aledomu/HispalisFPGA/board/HispalisFPGA.kicad_pcb

## KiCad design board/HispalisFPGA.kicad_pcb (2025-04-14)

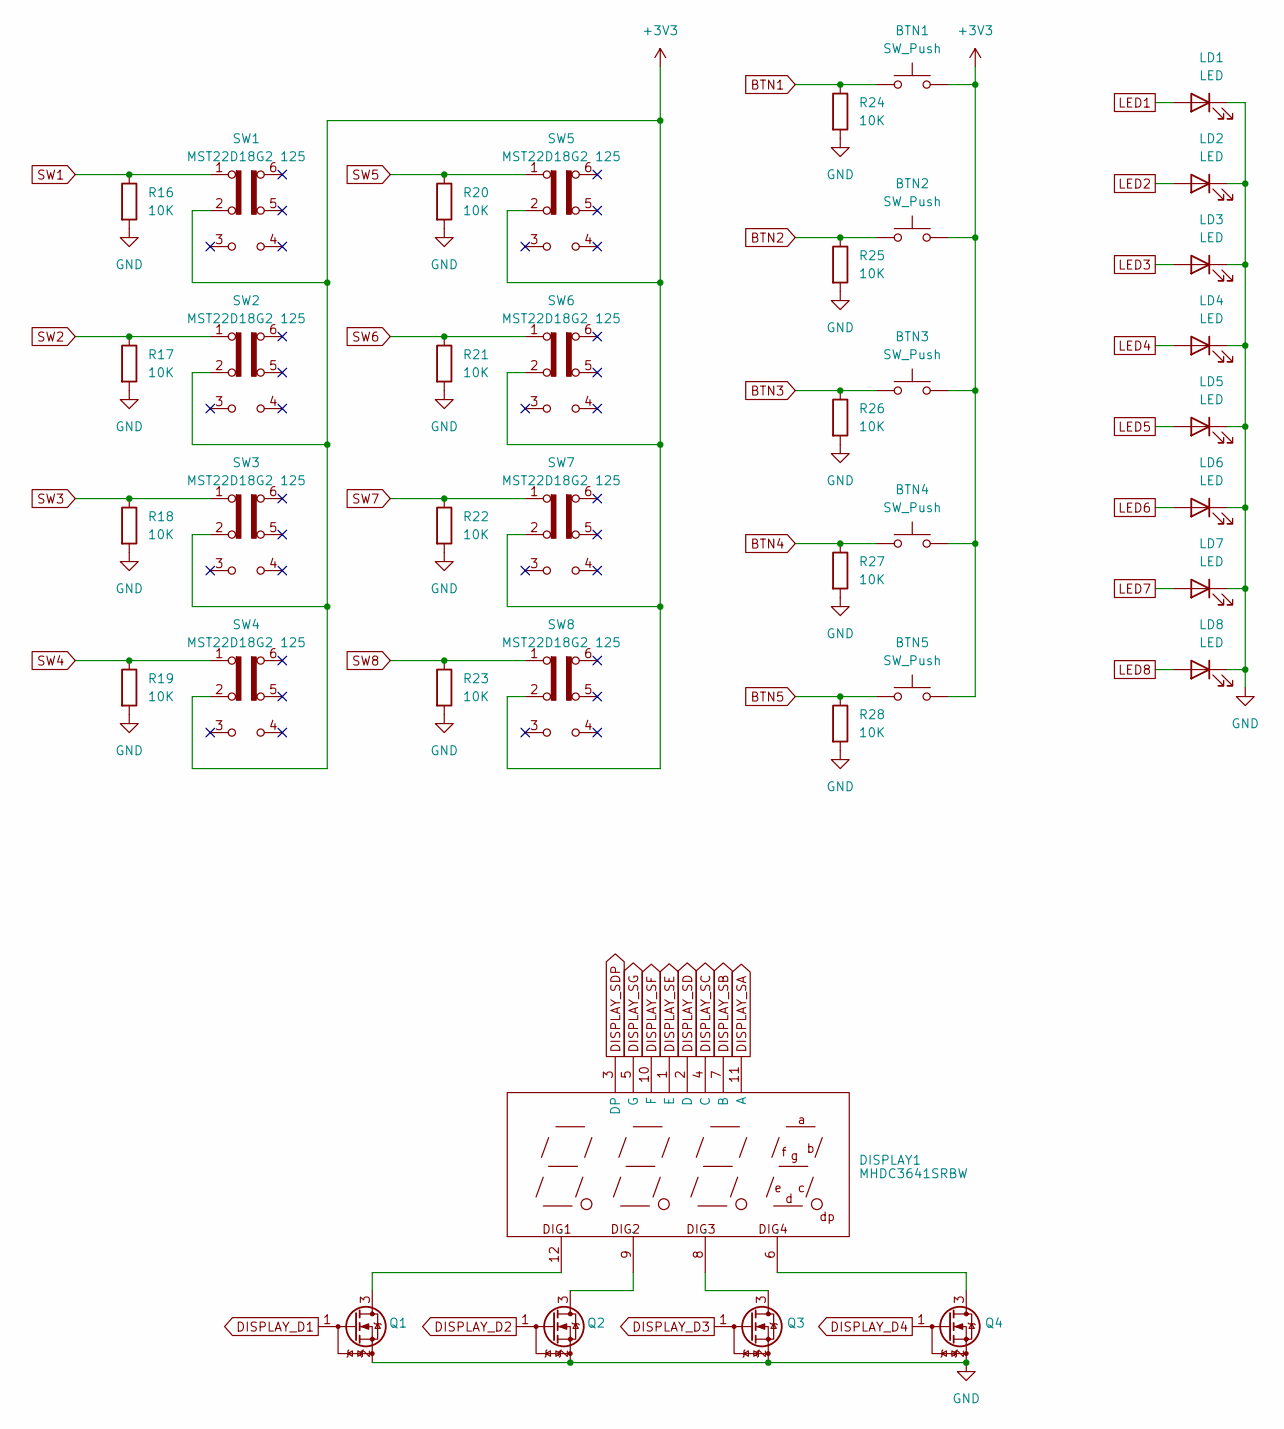
[picture p1: schematic onboard-devices.kicad_sch, HispalisFPGA Onboard Devices]

Parts:
BTN1, BTN2, BTN3, BTN4, BTN5: SW_Push; SW_PUSH_6mm; JLC Plugin,6x6mm
DISPLAY1: MHDC3641SRBW; LED-SEG-TH_12P-L30.0-W14.0-P2.54-LS10.2; Manufacturer Part MHDC3641SRBW; LCSC Part Name 0.36共阴四八红色数码管
LD1, LD2, LD3, LD4, LD5, LD6, LD7, LD8: LED; LED_0805_2012Metric; JLC 0805
Q1, Q2, Q3, Q4: DMG1012T; SOT-523; JLC SOT-523
R16, R17, R18, R19, R20, R21, R22, R23, R24, R25, R26, R27, R28: 10K; R_0402_1005Metric; JLC 0402
SW1, SW2, SW3, SW4, SW5, SW6, SW7, SW8: MST22D18G2 125; SW-SMD_MST22D18G2; JLC SMD

Connections:
+3V3: BTN1.2, BTN2.2, BTN3.2, BTN4.2, BTN5.2, SW1.2 (B), SW2.2 (B), SW3.2 (B), SW4.2 (B), SW5.2 (B), SW6.2 (B), SW7.2 (B), SW8.2 (B); also elsewhere on the board
BTN1: BTN1.1, R24.1; also elsewhere on the board
BTN2: BTN2.1, R25.1; also elsewhere on the board
BTN3: BTN3.1, R26.1; also elsewhere on the board
BTN4: BTN4.1, R27.1; also elsewhere on the board
BTN5: BTN5.1, R28.1; also elsewhere on the board
DISPLAY_D1: Q1.1 (G); also elsewhere on the board
DISPLAY_D2: Q2.1 (G); also elsewhere on the board
DISPLAY_D3: Q3.1 (G); also elsewhere on the board
DISPLAY_D4: Q4.1 (G); also elsewhere on the board
DISPLAY_SA: DISPLAY1.11 (A); also elsewhere on the board
DISPLAY_SB: DISPLAY1.7 (B); also elsewhere on the board
DISPLAY_SC: DISPLAY1.4 (C); also elsewhere on the board
DISPLAY_SD: DISPLAY1.2 (D); also elsewhere on the board
DISPLAY_SDP: DISPLAY1.3 (DP); also elsewhere on the board
DISPLAY_SE: DISPLAY1.1 (E); also elsewhere on the board
DISPLAY_SF: DISPLAY1.10 (F); also elsewhere on the board
DISPLAY_SG: DISPLAY1.5 (G); also elsewhere on the board
GND: LD1.1 (K), LD2.1 (K), LD3.1 (K), LD4.1 (K), LD5.1 (K), LD6.1 (K), LD7.1 (K), LD8.1 (K), Q1.2 (S), Q2.2 (S), Q3.2 (S), Q4.2 (S), R16.2, R17.2, R18.2, R19.2, R20.2, R21.2, R22.2, R23.2, R24.2, R25.2, R26.2, R27.2, R28.2; also elsewhere on the board
LED1: LD1.2 (A); also elsewhere on the board
LED2: LD2.2 (A); also elsewhere on the board
LED3: LD3.2 (A); also elsewhere on the board
LED4: LD4.2 (A); also elsewhere on the board
LED5: LD5.2 (A); also elsewhere on the board
LED6: LD6.2 (A); also elsewhere on the board
LED7: LD7.2 (A); also elsewhere on the board
LED8: LD8.2 (A); also elsewhere on the board
unnamed: DISPLAY1.12 (DIG1), Q1.3 (D)
unnamed: DISPLAY1.9 (DIG2), Q2.3 (D)
unnamed: DISPLAY1.8 (DIG3), Q3.3 (D)
unnamed: DISPLAY1.6 (DIG4), Q4.3 (D)
SW1: R16.1, SW1.1 (A); also elsewhere on the board
SW2: R17.1, SW2.1 (A); also elsewhere on the board
SW3: R18.1, SW3.1 (A); also elsewhere on the board
SW4: R19.1, SW4.1 (A); also elsewhere on the board
SW5: R20.1, SW5.1 (A); also elsewhere on the board
SW6: R21.1, SW6.1 (A); also elsewhere on the board
SW7: R22.1, SW7.1 (A); also elsewhere on the board
SW8: R23.1, SW8.1 (A); also elsewhere on the board

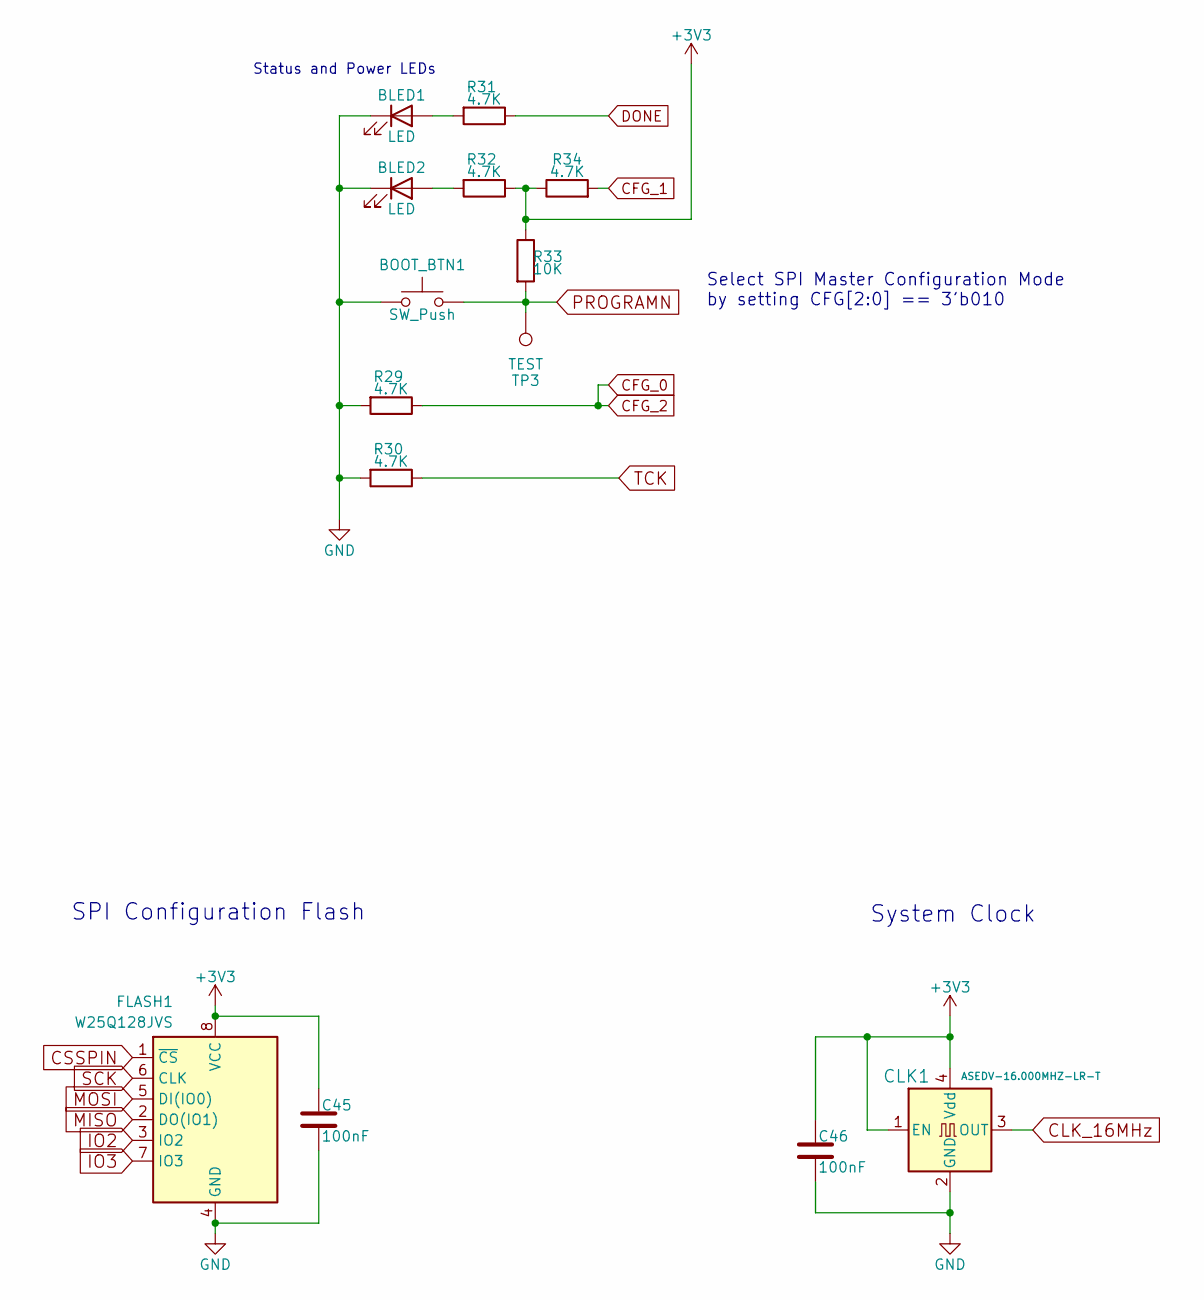
[picture p2: schematic ecp5-clock-and-programming.kicad_sch, HispalisFPGA ECP5 Clock and Programming]

Parts:
BLED1, BLED2: LED; LED_0603_1608Metric; JLC 0603
BOOT_BTN1: SW_Push; SW_PUSH_6mm; JLC Plugin,6x6mm
C45, C46: 100nF; C_0402_1005Metric; JLC 0402
CLK1: ASEDV-16.000MHZ-LR-T; Oscillator_SMD_Abracon_ASE-4Pin_3.2x2.5mm; JLC SMD3225-4P
FLASH1: W25Q128JVS; SOIC-8_5.23x5.23mm_P1.27mm; JLC SOIC-8-208mil
R29, R30, R31, R32, R34: 4.7K; R_0402_1005Metric; JLC 0402
R33: 10K; R_0402_1005Metric; JLC 0402
TP3: TEST; TestPoint_Pad_D1.0mm

Connections:
+3V3: C45.1, C46.1, CLK1.1 (EN), CLK1.4 (Vdd), FLASH1.8 (VCC), R32.1, R33.1, R34.1; also elsewhere on the board
CFG_0: R29.1; also elsewhere on the board
CFG_1: R34.2; also elsewhere on the board
CLK_16MHz: CLK1.3 (OUT); also elsewhere on the board
CSSPIN: FLASH1.1 (~CS); also elsewhere on the board
DONE: R31.1; also elsewhere on the board
GND: BLED1.1 (K), BLED2.1 (K), BOOT_BTN1.1, C45.2, C46.2, CLK1.2 (GND), FLASH1.4 (GND), R29.2, R30.2; also elsewhere on the board
IO2: FLASH1.3 (IO2); also elsewhere on the board
IO3: FLASH1.7 (IO3); also elsewhere on the board
MISO: FLASH1.2 (DO(IO1)); also elsewhere on the board
MOSI: FLASH1.5 (DI(IO0)); also elsewhere on the board
unnamed: BLED1.2 (A), R31.2
unnamed: BLED2.2 (A), R32.2
PROGRAMN: BOOT_BTN1.2, R33.2, TP3.1; also elsewhere on the board
SCK: FLASH1.6 (CLK); also elsewhere on the board
TCK: R30.1; also elsewhere on the board

Notes on the sheet:
System Clock
Status and Power LEDs
Select SPI Master Configuration Mode by setting CFG[2:0] == 3'b010
SPI Configuration Flash

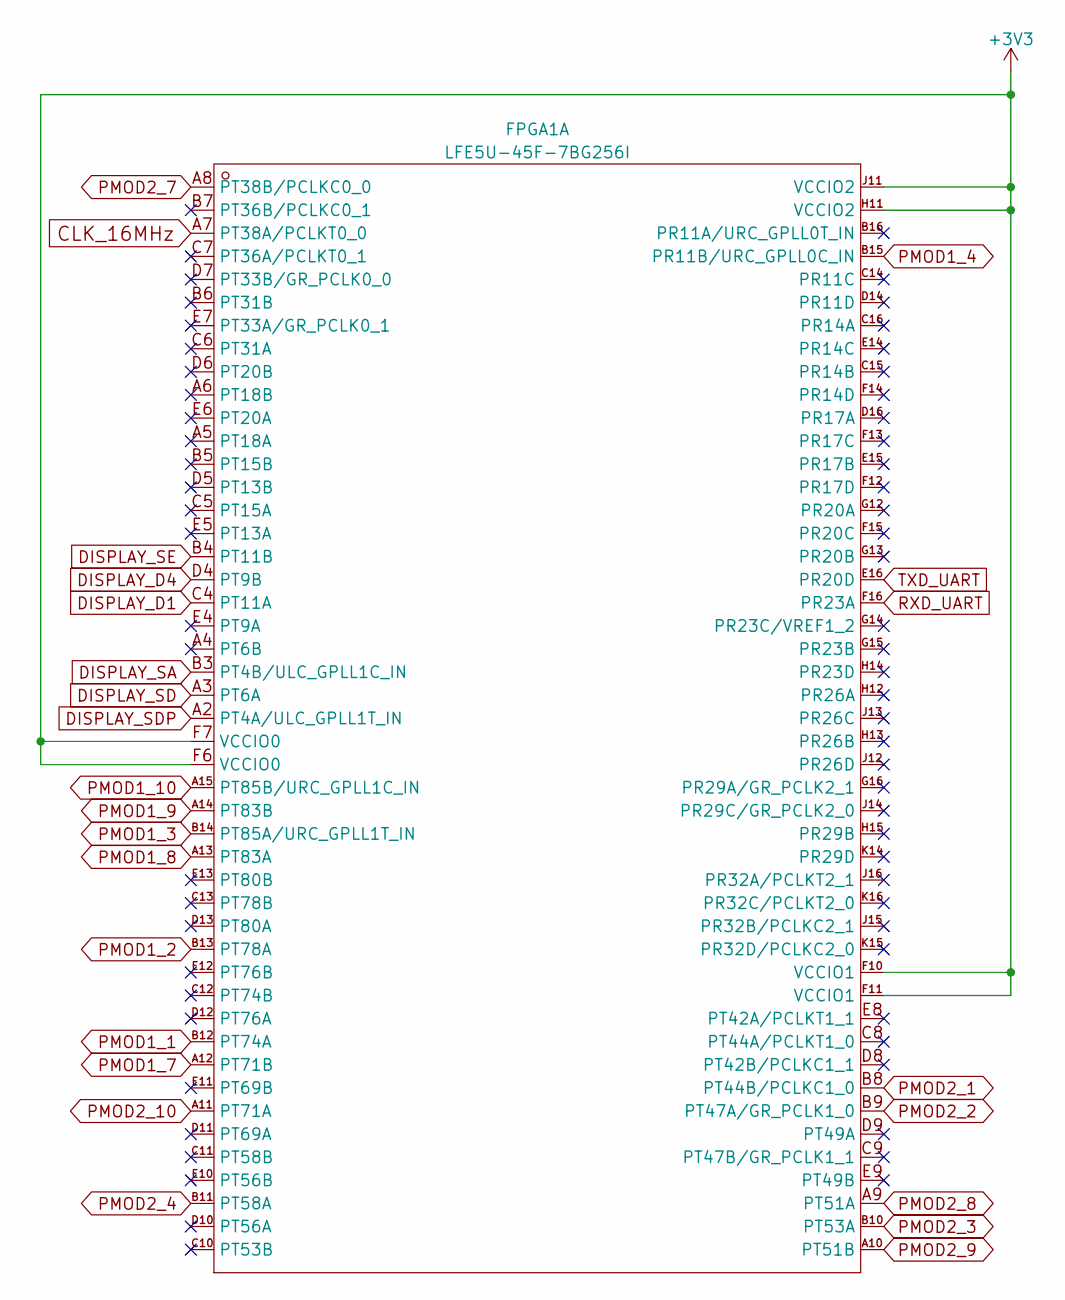
[picture p3: schematic ecp5-io-pins-1.kicad_sch, HispalisFPGA ECP5 I/O Pins]

Parts:
FPGA1: LFE5U-45F-7BG256I; CABGA-256_L14.0-W14.0-R16-C16-P0.80-TL; Manufacturer Part LFE5U-45F-7BG256I; LCSC Part Name LFE5U 45F 7BG256I

Connections:
+3V3: FPGA1.F6 (VCCIO0), FPGA1.F7 (VCCIO0), FPGA1.F10 (VCCIO1), FPGA1.F11 (VCCIO1), FPGA1.H11 (VCCIO2), FPGA1.J11 (VCCIO2); also elsewhere on the board
CLK_16MHz: FPGA1.A7 (PT38A/PCLKT0_0); also elsewhere on the board
DISPLAY_D1: FPGA1.C4 (PT11A); also elsewhere on the board
DISPLAY_D4: FPGA1.D4 (PT9B); also elsewhere on the board
DISPLAY_SA: FPGA1.B3 (PT4B/ULC_GPLL1C_IN); also elsewhere on the board
DISPLAY_SD: FPGA1.A3 (PT6A); also elsewhere on the board
DISPLAY_SDP: FPGA1.A2 (PT4A/ULC_GPLL1T_IN); also elsewhere on the board
DISPLAY_SE: FPGA1.B4 (PT11B); also elsewhere on the board
PMOD1_1: FPGA1.B12 (PT74A); also elsewhere on the board
PMOD1_2: FPGA1.B13 (PT78A); also elsewhere on the board
PMOD1_3: FPGA1.B14 (PT85A/URC_GPLL1T_IN); also elsewhere on the board
PMOD1_4: FPGA1.B15 (PR11B/URC_GPLL0C_IN); also elsewhere on the board
PMOD1_7: FPGA1.A12 (PT71B); also elsewhere on the board
PMOD1_8: FPGA1.A13 (PT83A); also elsewhere on the board
PMOD1_9: FPGA1.A14 (PT83B); also elsewhere on the board
PMOD1_10: FPGA1.A15 (PT85B/URC_GPLL1C_IN); also elsewhere on the board
PMOD2_1: FPGA1.B8 (PT44B/PCLKC1_0); also elsewhere on the board
PMOD2_2: FPGA1.B9 (PT47A/GR_PCLK1_0); also elsewhere on the board
PMOD2_3: FPGA1.B10 (PT53A); also elsewhere on the board
PMOD2_4: FPGA1.B11 (PT58A); also elsewhere on the board
PMOD2_7: FPGA1.A8 (PT38B/PCLKC0_0); also elsewhere on the board
PMOD2_8: FPGA1.A9 (PT51A); also elsewhere on the board
PMOD2_9: FPGA1.A10 (PT51B); also elsewhere on the board
PMOD2_10: FPGA1.A11 (PT71A); also elsewhere on the board
RXD_UART: FPGA1.F16 (PR23A); also elsewhere on the board
TXD_UART: FPGA1.E16 (PR20D); also elsewhere on the board

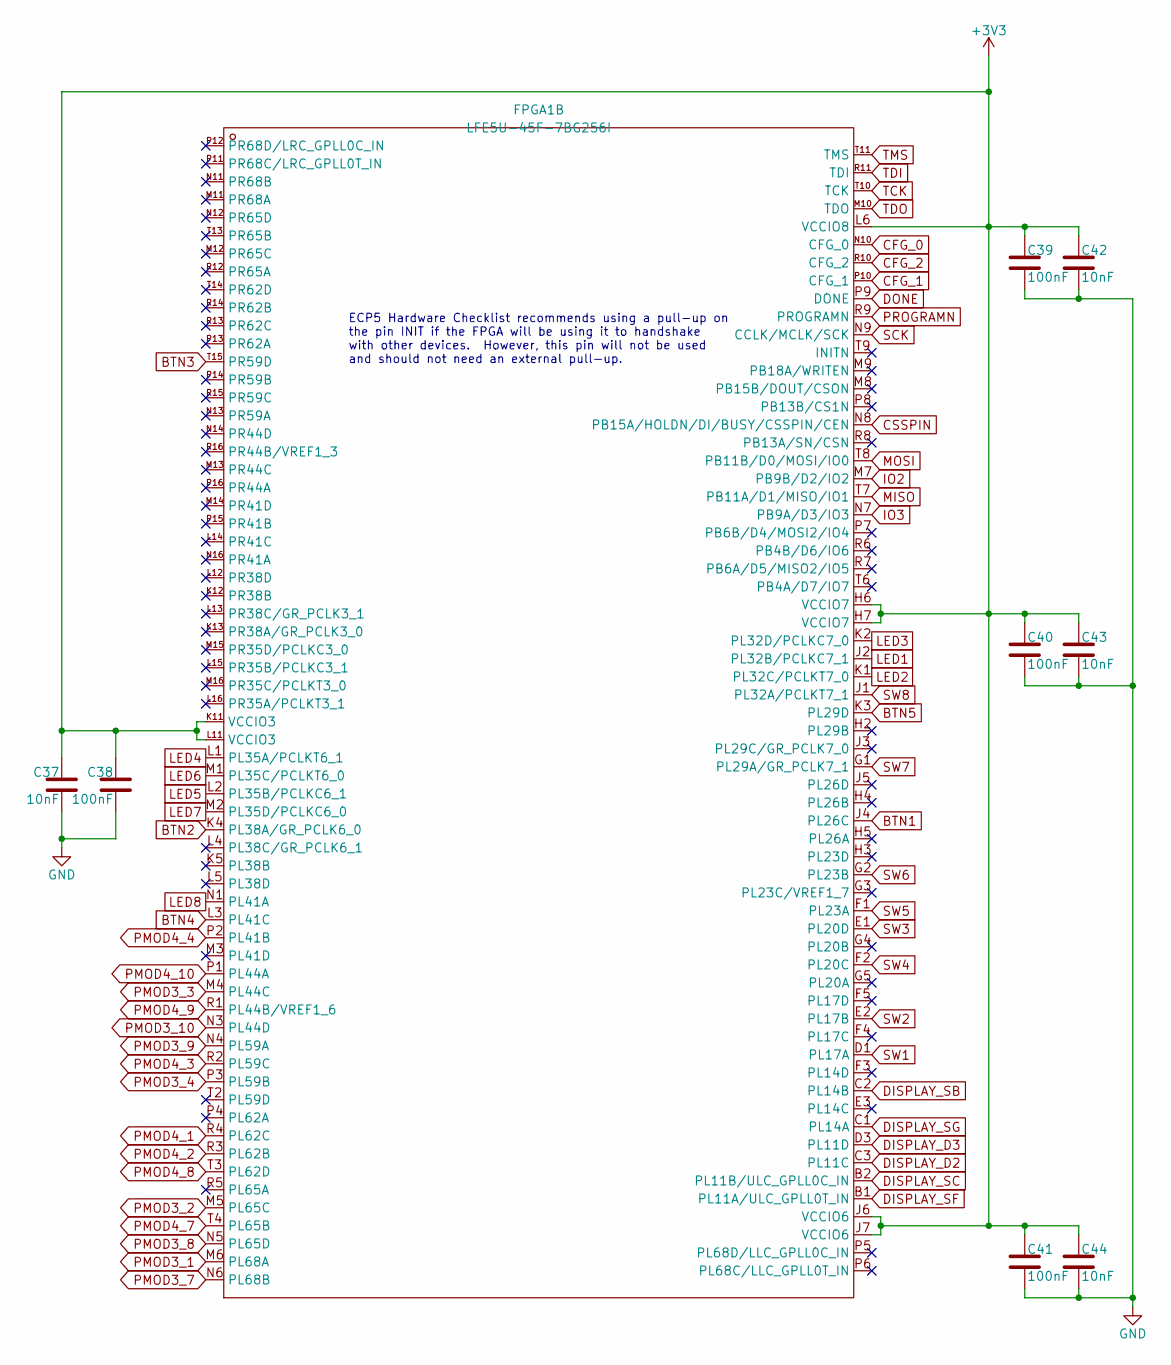
[picture p4: schematic ecp5-io-pins-2.kicad_sch]

Parts:
C37, C42, C43, C44: 10nF; C_0402_1005Metric; JLC 0402
C38, C39, C40, C41: 100nF; C_0402_1005Metric; JLC 0402
FPGA1: LFE5U-45F-7BG256I; CABGA-256_L14.0-W14.0-R16-C16-P0.80-TL; Manufacturer Part LFE5U-45F-7BG256I; LCSC Part Name LFE5U 45F 7BG256I

Connections:
+3V3: C37.1, C38.1, C39.1, C40.1, C41.1, C42.1, C43.1, C44.1, FPGA1.H6 (VCCIO7), FPGA1.H7 (VCCIO7), FPGA1.J6 (VCCIO6), FPGA1.J7 (VCCIO6), FPGA1.K11 (VCCIO3), FPGA1.L6 (VCCIO8), FPGA1.L11 (VCCIO3); also elsewhere on the board
BTN1: FPGA1.J4 (PL26C); also elsewhere on the board
BTN2: FPGA1.K4 (PL38A/GR_PCLK6_0); also elsewhere on the board
BTN3: FPGA1.T15 (PR59D); also elsewhere on the board
BTN4: FPGA1.L3 (PL41C); also elsewhere on the board
BTN5: FPGA1.K3 (PL29D); also elsewhere on the board
CFG_0: FPGA1.N10 (CFG_0), FPGA1.R10 (CFG_2); also elsewhere on the board
CFG_1: FPGA1.P10 (CFG_1); also elsewhere on the board
CSSPIN: FPGA1.N8 (PB15A/HOLDN/DI/BUSY/CSSPIN/CEN); also elsewhere on the board
DISPLAY_D2: FPGA1.C3 (PL11C); also elsewhere on the board
DISPLAY_D3: FPGA1.D3 (PL11D); also elsewhere on the board
DISPLAY_SB: FPGA1.C2 (PL14B); also elsewhere on the board
DISPLAY_SC: FPGA1.B2 (PL11B/ULC_GPLL0C_IN); also elsewhere on the board
DISPLAY_SF: FPGA1.B1 (PL11A/ULC_GPLL0T_IN); also elsewhere on the board
DISPLAY_SG: FPGA1.C1 (PL14A); also elsewhere on the board
DONE: FPGA1.P9 (DONE); also elsewhere on the board
GND: C37.2, C38.2, C39.2, C40.2, C41.2, C42.2, C43.2, C44.2; also elsewhere on the board
IO2: FPGA1.M7 (PB9B/D2/IO2); also elsewhere on the board
IO3: FPGA1.N7 (PB9A/D3/IO3); also elsewhere on the board
LED1: FPGA1.J2 (PL32B/PCLKC7_1); also elsewhere on the board
LED2: FPGA1.K1 (PL32C/PCLKT7_0); also elsewhere on the board
LED3: FPGA1.K2 (PL32D/PCLKC7_0); also elsewhere on the board
LED4: FPGA1.L1 (PL35A/PCLKT6_1); also elsewhere on the board
LED5: FPGA1.L2 (PL35B/PCLKC6_1); also elsewhere on the board
LED6: FPGA1.M1 (PL35C/PCLKT6_0); also elsewhere on the board
LED7: FPGA1.M2 (PL35D/PCLKC6_0); also elsewhere on the board
LED8: FPGA1.N1 (PL41A); also elsewhere on the board
MISO: FPGA1.T7 (PB11A/D1/MISO/IO1); also elsewhere on the board
MOSI: FPGA1.T8 (PB11B/D0/MOSI/IO0); also elsewhere on the board
PMOD3_1: FPGA1.M6 (PL68A); also elsewhere on the board
PMOD3_2: FPGA1.M5 (PL65C); also elsewhere on the board
PMOD3_3: FPGA1.M4 (PL44C); also elsewhere on the board
PMOD3_4: FPGA1.P3 (PL59B); also elsewhere on the board
PMOD3_7: FPGA1.N6 (PL68B); also elsewhere on the board
PMOD3_8: FPGA1.N5 (PL65D); also elsewhere on the board
PMOD3_9: FPGA1.N4 (PL59A); also elsewhere on the board
PMOD3_10: FPGA1.N3 (PL44D); also elsewhere on the board
PMOD4_1: FPGA1.R4 (PL62C); also elsewhere on the board
PMOD4_2: FPGA1.R3 (PL62B); also elsewhere on the board
PMOD4_3: FPGA1.R2 (PL59C); also elsewhere on the board
PMOD4_4: FPGA1.P2 (PL41B); also elsewhere on the board
PMOD4_7: FPGA1.T4 (PL65B); also elsewhere on the board
PMOD4_8: FPGA1.T3 (PL62D); also elsewhere on the board
PMOD4_9: FPGA1.R1 (PL44B/VREF1_6); also elsewhere on the board
PMOD4_10: FPGA1.P1 (PL44A); also elsewhere on the board
PROGRAMN: FPGA1.R9 (PROGRAMN); also elsewhere on the board
SCK: FPGA1.N9 (CCLK/MCLK/SCK); also elsewhere on the board
SW1: FPGA1.D1 (PL17A); also elsewhere on the board
SW2: FPGA1.E2 (PL17B); also elsewhere on the board
SW3: FPGA1.E1 (PL20D); also elsewhere on the board
SW4: FPGA1.F2 (PL20C); also elsewhere on the board
SW5: FPGA1.F1 (PL23A); also elsewhere on the board
SW6: FPGA1.G2 (PL23B); also elsewhere on the board
SW7: FPGA1.G1 (PL29A/GR_PCLK7_1); also elsewhere on the board
SW8: FPGA1.J1 (PL32A/PCLKT7_1); also elsewhere on the board
TCK: FPGA1.T10 (TCK); also elsewhere on the board
TDI: FPGA1.R11 (TDI); also elsewhere on the board
TDO: FPGA1.M10 (TDO); also elsewhere on the board
TMS: FPGA1.T11 (TMS); also elsewhere on the board

Notes on the sheet:
ECP5 Hardware Checklist recommends using a pull-up on the pin INIT if the FPGA will be using it to handshake with other devices. However, this pin will not be used and should not need an external pull-up.

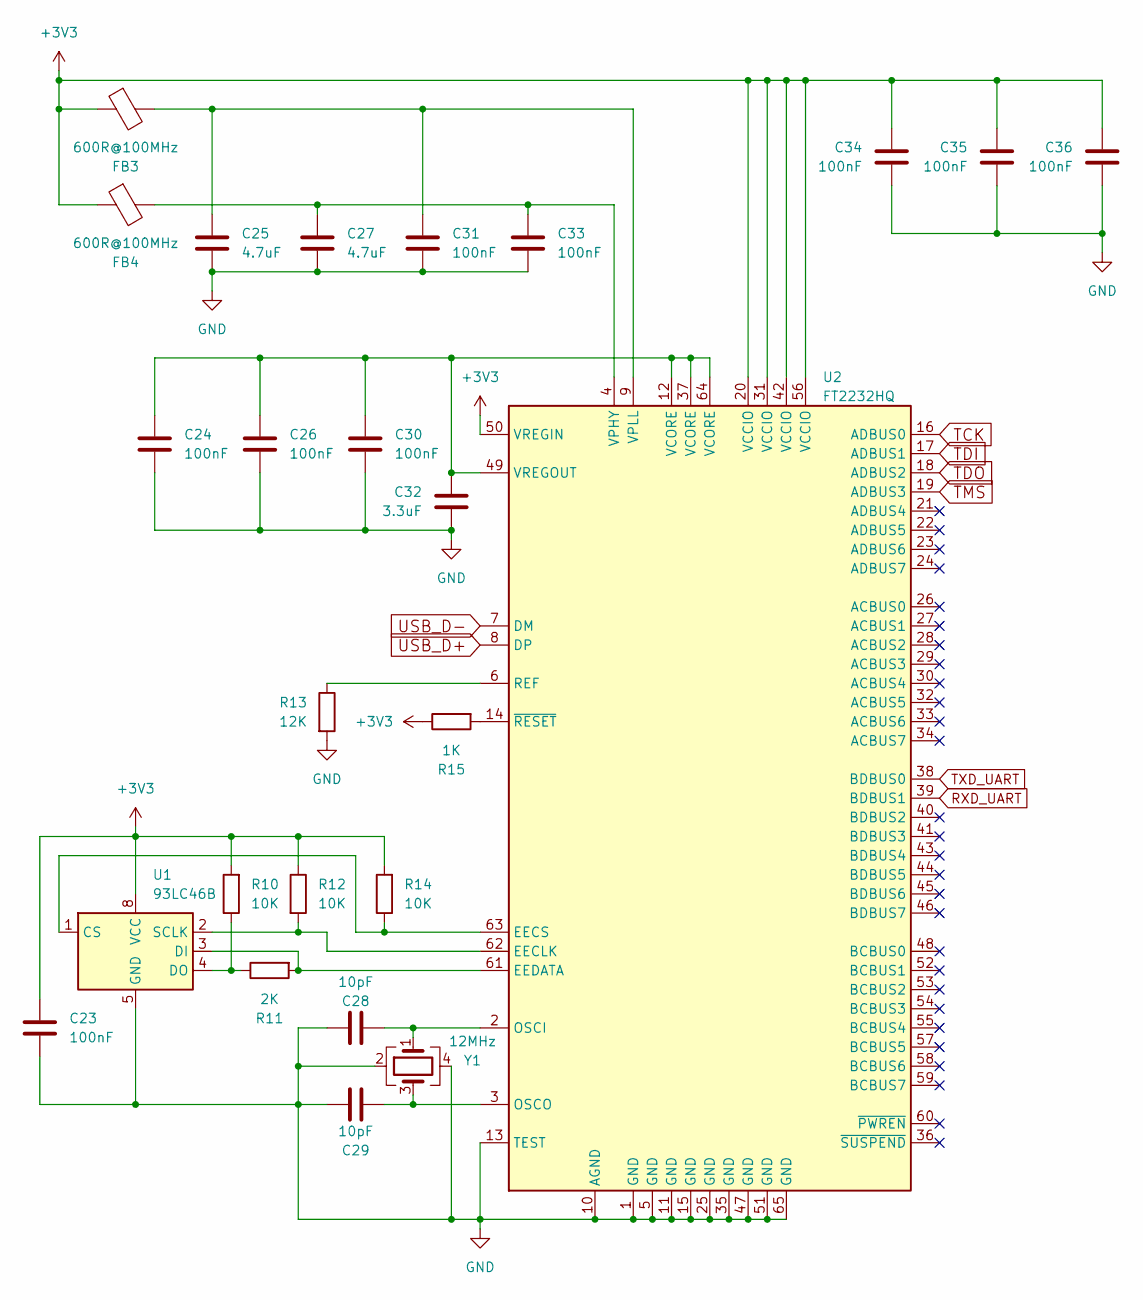
[picture p5: schematic ftdi-usb-controller.kicad_sch, HispalisFPGA USB Controller for JTAG and UART]

Parts:
C23, C24, C26, C30, C31, C33, C34, C35, C36: 100nF; C_0402_1005Metric; JLC 0402
C25, C27: 4.7uF; C_0402_1005Metric; JLC 0402
C28, C29: 10pF; C_0402_1005Metric; JLC 0402
C32: 3.3uF; C_0402_1005Metric; JLC 0402
FB3, FB4: 600R@100MHz; L_0603_1608Metric; JLC 0603
R10, R12, R14: 10K; R_0402_1005Metric; JLC 0402
R11: 2K; R_0402_1005Metric; JLC 0402
R13: 12K; R_0402_1005Metric; JLC 0402
R15: 1K; R_0402_1005Metric; JLC 0402
U1: 93LC46B; TSSOP-8_4.4x3mm_P0.65mm; JLC TSSOP-8
U2: FT2232HQ; QFN-64-1EP_9x9mm_P0.5mm_EP4.35x4.35mm; JLC QFN-64-EP(9x9)
Y1: 12MHz; Crystal_SMD_2520-4Pin_2.5x2.0mm; JLC SMD2520-4P

Connections:
+3V3: C23.1, C34.1, C35.1, C36.1, FB3.1, FB4.1, R10.2, R12.1, R14.2, R15.1, U1.8 (VCC), U2.20 (VCCIO), U2.31 (VCCIO), U2.42 (VCCIO), U2.50 (VREGIN), U2.56 (VCCIO); also elsewhere on the board
GND: C23.2, C24.2, C25.2, C26.2, C27.2, C28.1, C29.1, C30.2, C31.2, C32.2, C33.2, C34.2, C35.2, C36.2, R13.2, U1.5 (GND), U2.1 (GND), U2.5 (GND), U2.10 (AGND), U2.11 (GND), U2.13 (TEST), U2.15 (GND), U2.25 (GND), U2.35 (GND), U2.47 (GND), U2.51 (GND), U2.65 (GND), Y1.2, Y1.4; also elsewhere on the board
unnamed: R14.1, U1.1 (CS), U2.63 (EECS)
unnamed: R11.2, U1.3 (DI), U2.61 (EEDATA)
unnamed: R10.1, R11.1, U1.4 (DO)
unnamed: R12.2, U1.2 (SCLK), U2.62 (EECLK)
unnamed: C28.2, U2.2 (OSCI), Y1.1
unnamed: C29.2, U2.3 (OSCO), Y1.3
unnamed: R13.1, U2.6 (REF)
unnamed: C27.1, C33.1, FB4.2, U2.4 (VPHY)
unnamed: C25.1, C31.1, FB3.2, U2.9 (VPLL)
unnamed: C24.1, C26.1, C30.1, C32.1, U2.12 (VCORE), U2.37 (VCORE), U2.49 (VREGOUT), U2.64 (VCORE)
unnamed: R15.2, U2.14 (~RESET)
RXD_UART: U2.39 (BDBUS1); also elsewhere on the board
TCK: U2.16 (ADBUS0); also elsewhere on the board
TDI: U2.17 (ADBUS1); also elsewhere on the board
TDO: U2.18 (ADBUS2); also elsewhere on the board
TMS: U2.19 (ADBUS3); also elsewhere on the board
TXD_UART: U2.38 (BDBUS0); also elsewhere on the board
USB_D+: U2.8 (DP); also elsewhere on the board
USB_D-: U2.7 (DM); also elsewhere on the board

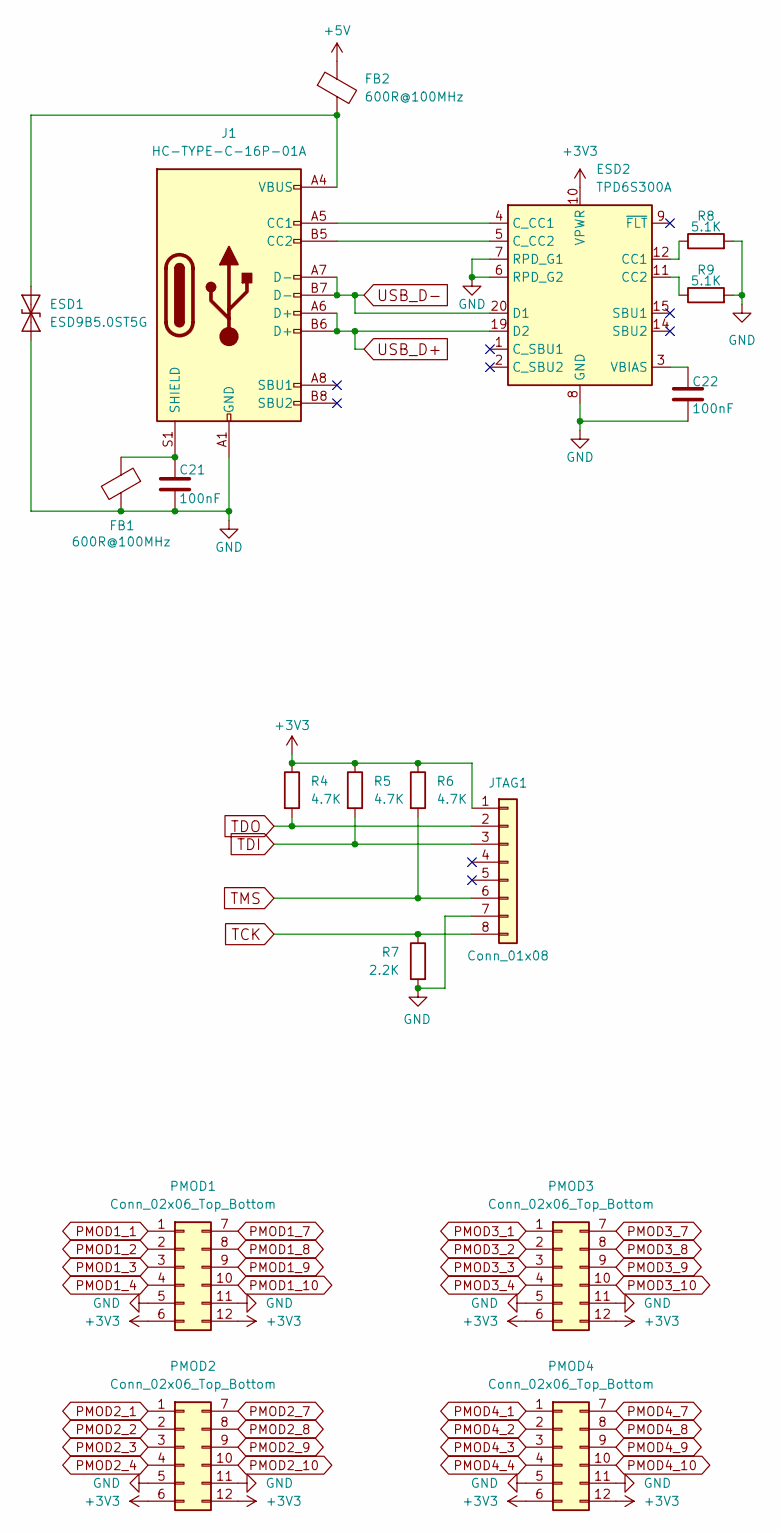
[picture p6: schematic ports.kicad_sch, HispalisFPGA Ports]

Parts:
C21, C22: 100nF; C_0402_1005Metric; JLC 0402
ESD1: ESD9B5.0ST5G; D_SOD-923; JLC SOD-923
ESD2: TPD6S300A; WQFN-20-1EP_3x3mm_P0.4mm_EP1.7x1.7mm_ThermalVias; JLC WQFN-20-EP(3x3)
FB1, FB2: 600R@100MHz; L_0603_1608Metric; JLC 0603
J1: HC-TYPE-C-16P-01A; USB_C_Receptacle_HCTL_HC-TYPE-C-16P-01A; JLC SMD
JTAG1: Conn_01x08; PinHeader_1x08_P2.54mm_Vertical; JLC Plugin,P=2.54mm
PMOD1, PMOD2, PMOD3, PMOD4: Conn_02x06_Top_Bottom; PMOD_Socket_Horizontal; JLC Push-Pull,P=2.5mm
R4, R5, R6: 4.7K; R_0402_1005Metric; JLC 0402
R7: 2.2K; R_0402_1005Metric; JLC 0402
R8, R9: 5.1K; R_0402_1005Metric; JLC 0402

Connections:
+3V3: ESD2.10 (VPWR), JTAG1.1, PMOD1.6, PMOD1.12, PMOD2.6, PMOD2.12, PMOD3.6, PMOD3.12, PMOD4.6, PMOD4.12, R4.1, R5.1, R6.1; also elsewhere on the board
+5V: FB2.1; also elsewhere on the board
GND: C21.2, C22.2, ESD1.1 (A1), ESD2.6 (RPD_G2), ESD2.7 (RPD_G1), ESD2.8 (GND), ESD2.13 (GND), ESD2.16 (GND), ESD2.17 (GND), ESD2.18 (GND), ESD2.21 (GND), FB1.2, J1.A1 (GND), J1.A12 (GND), J1.B1 (GND), J1.B12 (GND), JTAG1.7, PMOD1.5, PMOD1.11, PMOD2.5, PMOD2.11, PMOD3.5, PMOD3.11, PMOD4.5, PMOD4.11, R7.2, R8.2, R9.2; also elsewhere on the board
unnamed: ESD1.2 (A2), FB2.2, J1.A4 (VBUS), J1.A9 (VBUS), J1.B4 (VBUS), J1.B9 (VBUS)
unnamed: ESD2.12 (CC1), R8.1
unnamed: ESD2.11 (CC2), R9.1
unnamed: ESD2.4 (C_CC1), J1.A5 (CC1)
unnamed: ESD2.5 (C_CC2), J1.B5 (CC2)
unnamed: C22.1, ESD2.3 (VBIAS)
unnamed: C21.1, FB1.1, J1.S1 (SHIELD)
PMOD1_1: PMOD1.1; also elsewhere on the board
PMOD1_2: PMOD1.2; also elsewhere on the board
PMOD1_3: PMOD1.3; also elsewhere on the board
PMOD1_4: PMOD1.4; also elsewhere on the board
PMOD1_7: PMOD1.7; also elsewhere on the board
PMOD1_8: PMOD1.8; also elsewhere on the board
PMOD1_9: PMOD1.9; also elsewhere on the board
PMOD1_10: PMOD1.10; also elsewhere on the board
PMOD2_1: PMOD2.1; also elsewhere on the board
PMOD2_2: PMOD2.2; also elsewhere on the board
PMOD2_3: PMOD2.3; also elsewhere on the board
PMOD2_4: PMOD2.4; also elsewhere on the board
PMOD2_7: PMOD2.7; also elsewhere on the board
PMOD2_8: PMOD2.8; also elsewhere on the board
PMOD2_9: PMOD2.9; also elsewhere on the board
PMOD2_10: PMOD2.10; also elsewhere on the board
PMOD3_1: PMOD3.1; also elsewhere on the board
PMOD3_2: PMOD3.2; also elsewhere on the board
PMOD3_3: PMOD3.3; also elsewhere on the board
PMOD3_4: PMOD3.4; also elsewhere on the board
PMOD3_7: PMOD3.7; also elsewhere on the board
PMOD3_8: PMOD3.8; also elsewhere on the board
PMOD3_9: PMOD3.9; also elsewhere on the board
PMOD3_10: PMOD3.10; also elsewhere on the board
PMOD4_1: PMOD4.1; also elsewhere on the board
PMOD4_2: PMOD4.2; also elsewhere on the board
PMOD4_3: PMOD4.3; also elsewhere on the board
PMOD4_4: PMOD4.4; also elsewhere on the board
PMOD4_7: PMOD4.7; also elsewhere on the board
PMOD4_8: PMOD4.8; also elsewhere on the board
PMOD4_9: PMOD4.9; also elsewhere on the board
PMOD4_10: PMOD4.10; also elsewhere on the board
TCK: JTAG1.8, R7.1; also elsewhere on the board
TDI: JTAG1.3, R5.2; also elsewhere on the board
TDO: JTAG1.2, R4.2; also elsewhere on the board
TMS: JTAG1.6, R6.2; also elsewhere on the board
USB_D+: ESD2.19 (D2), J1.A6 (D+), J1.B6 (D+); also elsewhere on the board
USB_D-: ESD2.20 (D1), J1.A7 (D-), J1.B7 (D-); also elsewhere on the board

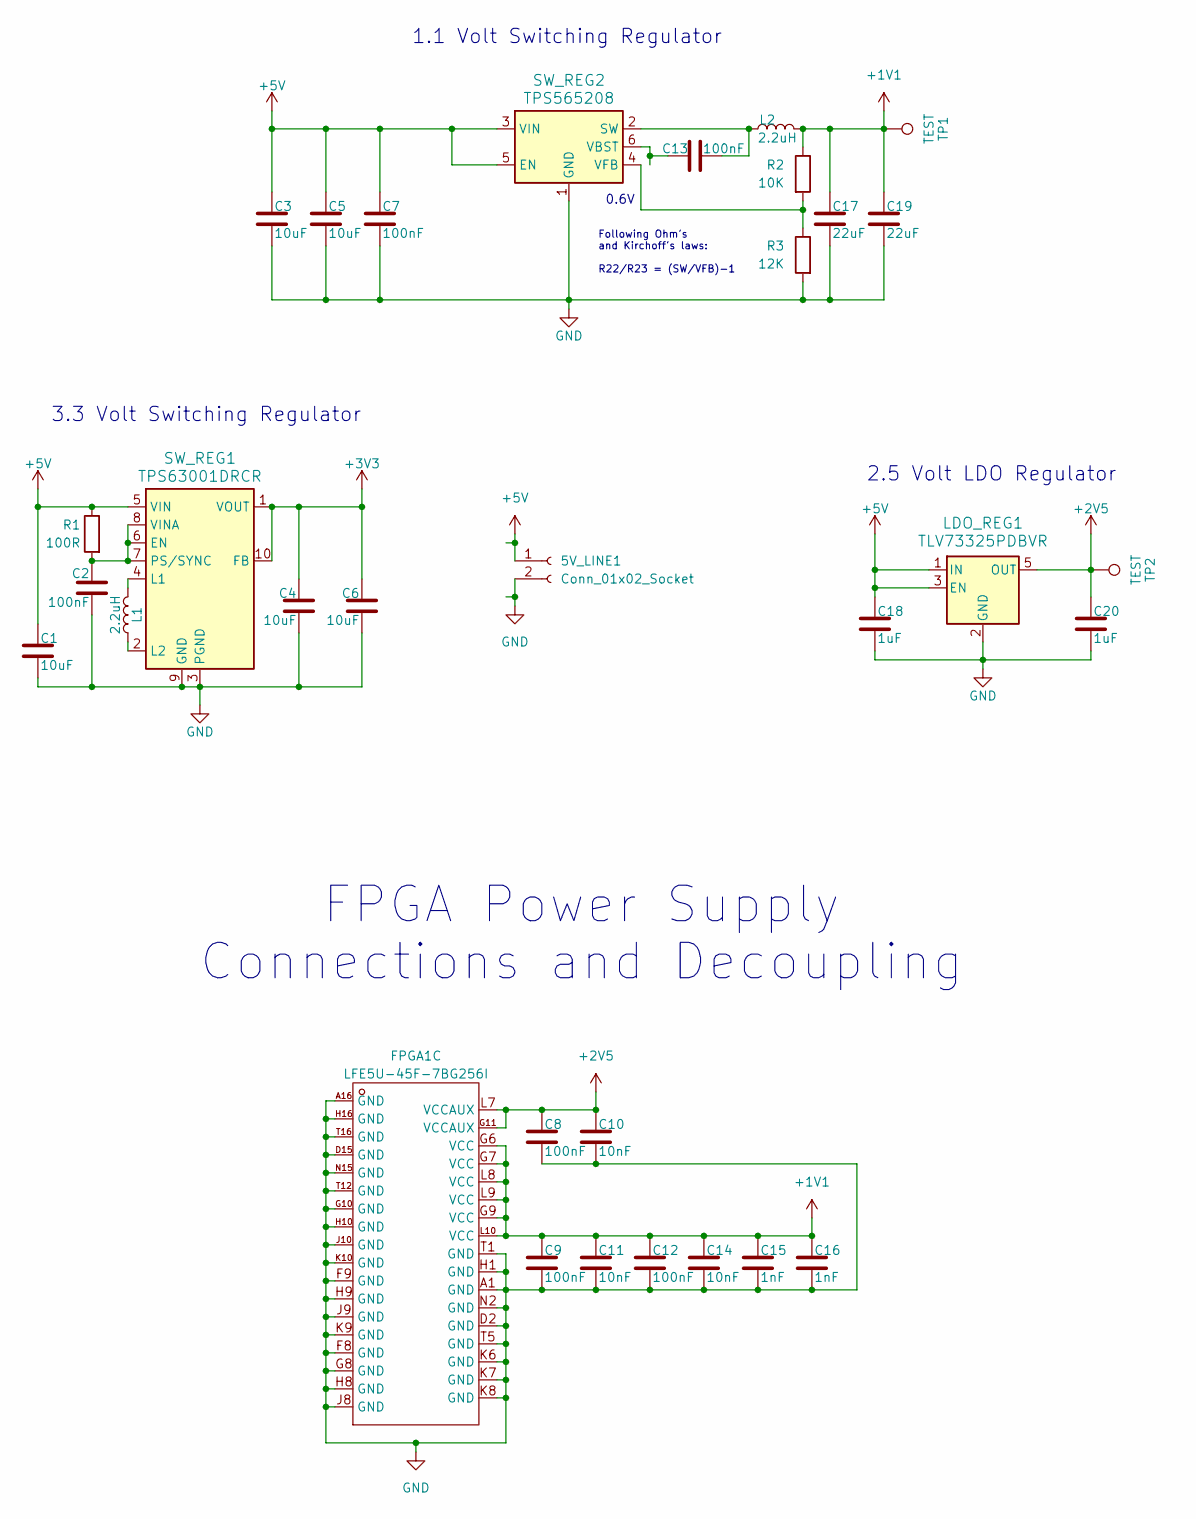
[picture p7: schematic power.kicad_sch, HispalisFPGA Power]

Parts:
5V_LINE1: Conn_01x02_Socket; PinSocket_1x02_P2.54mm_Vertical; JLC Plugin,P=2.54mm
C1, C3, C4, C5, C6: 10uF; C_0603_1608Metric; JLC 0603
C2, C7, C8, C9, C12, C13: 100nF; C_0402_1005Metric; JLC 0402
C10, C11, C14: 10nF; C_0402_1005Metric; JLC 0402
C15, C16: 1nF; C_0402_1005Metric; JLC 0402
C17, C19: 22uF; C_0603_1608Metric; JLC 0603
C18, C20: 1uF; C_0402_1005Metric; JLC 0402
FPGA1: LFE5U-45F-7BG256I; CABGA-256_L14.0-W14.0-R16-C16-P0.80-TL; Manufacturer Part LFE5U-45F-7BG256I; LCSC Part Name LFE5U 45F 7BG256I
L1, L2: 2.2uH; L_0805_2012Metric; JLC 0805
LDO_REG1: TLV73325PDBVR; SOT-23-5; JLC SOT-23-5
R1: 100R; R_0402_1005Metric; JLC 0402
R2: 10K; R_0402_1005Metric; JLC 0402
R3: 12K; R_0402_1005Metric; JLC 0402
SW_REG1: TPS63001DRCR; Texas_DRC0010J_ThermalVias; JLC VSON-10-EP(3x3)
SW_REG2: TPS565208; SOT-23-6; JLC TSOT-23-6
TP1, TP2: TEST; TestPoint_Pad_D1.0mm

Connections:
+1V1: C9.1, C11.1, C12.1, C14.1, C15.1, C16.1, C17.1, C19.1, FPGA1.G6 (VCC), FPGA1.G7 (VCC), FPGA1.G9 (VCC), FPGA1.L8 (VCC), FPGA1.L9 (VCC), FPGA1.L10 (VCC), L2.2, R2.1, TP1.1
+2V5: C8.1, C10.1, C20.1, FPGA1.G11 (VCCAUX), FPGA1.L7 (VCCAUX), LDO_REG1.5 (OUT), TP2.1
+3V3: C4.1, C6.1, SW_REG1.1 (VOUT), SW_REG1.10 (FB); also elsewhere on the board
+5V: 5V_LINE1.1, C1.1, C3.1, C5.1, C7.1, C18.1, LDO_REG1.1 (IN), LDO_REG1.3 (EN), R1.1, SW_REG1.5 (VIN), SW_REG2.3 (VIN), SW_REG2.5 (EN); also elsewhere on the board
GND: 5V_LINE1.2, C1.2, C2.1, C3.2, C4.2, C5.2, C6.2, C7.2, C8.2, C9.2, C10.2, C11.2, C12.2, C14.2, C15.2, C16.2, C17.2, C18.2, C19.2, C20.2, FPGA1.A1 (GND), FPGA1.A16 (GND), FPGA1.D2 (GND), FPGA1.D15 (GND), FPGA1.F8 (GND), FPGA1.F9 (GND), FPGA1.G8 (GND), FPGA1.G10 (GND), FPGA1.H1 (GND), FPGA1.H8 (GND), FPGA1.H9 (GND), FPGA1.H10 (GND), FPGA1.H16 (GND), FPGA1.J8 (GND), FPGA1.J9 (GND), FPGA1.J10 (GND), FPGA1.K6 (GND), FPGA1.K7 (GND), FPGA1.K8 (GND), FPGA1.K9 (GND), FPGA1.K10 (GND), FPGA1.N2 (GND), FPGA1.N15 (GND), FPGA1.T1 (GND), FPGA1.T5 (GND), FPGA1.T12 (GND), FPGA1.T16 (GND), LDO_REG1.2 (GND), R3.2, SW_REG1.3 (PGND), SW_REG1.9 (GND), SW_REG1.11 (PGND), SW_REG2.1 (GND); also elsewhere on the board
unnamed: C2.2, R1.2, SW_REG1.6 (EN), SW_REG1.7 (PS/SYNC), SW_REG1.8 (VINA)
unnamed: L1.2, SW_REG1.4 (L1)
unnamed: L1.1, SW_REG1.2 (L2)
unnamed: C13.2, L2.1, SW_REG2.2 (SW)
unnamed: C13.1, SW_REG2.6 (VBST)
unnamed: R2.2, R3.1, SW_REG2.4 (VFB)

Notes on the sheet:
1.1 Volt Switching Regulator
FPGA Power Supply Connections and Decoupling
2.5 Volt LDO Regulator
Following Ohm's and Kirchoff's laws: R22/R23 = (SW/VFB)-1
0.6V
3.3 Volt Switching Regulator
