aledomu/HispalisFPGA/board/HispalisFPGA.kicad_pcb

## KiCad design board/HispalisFPGA.kicad_pcb (continued)

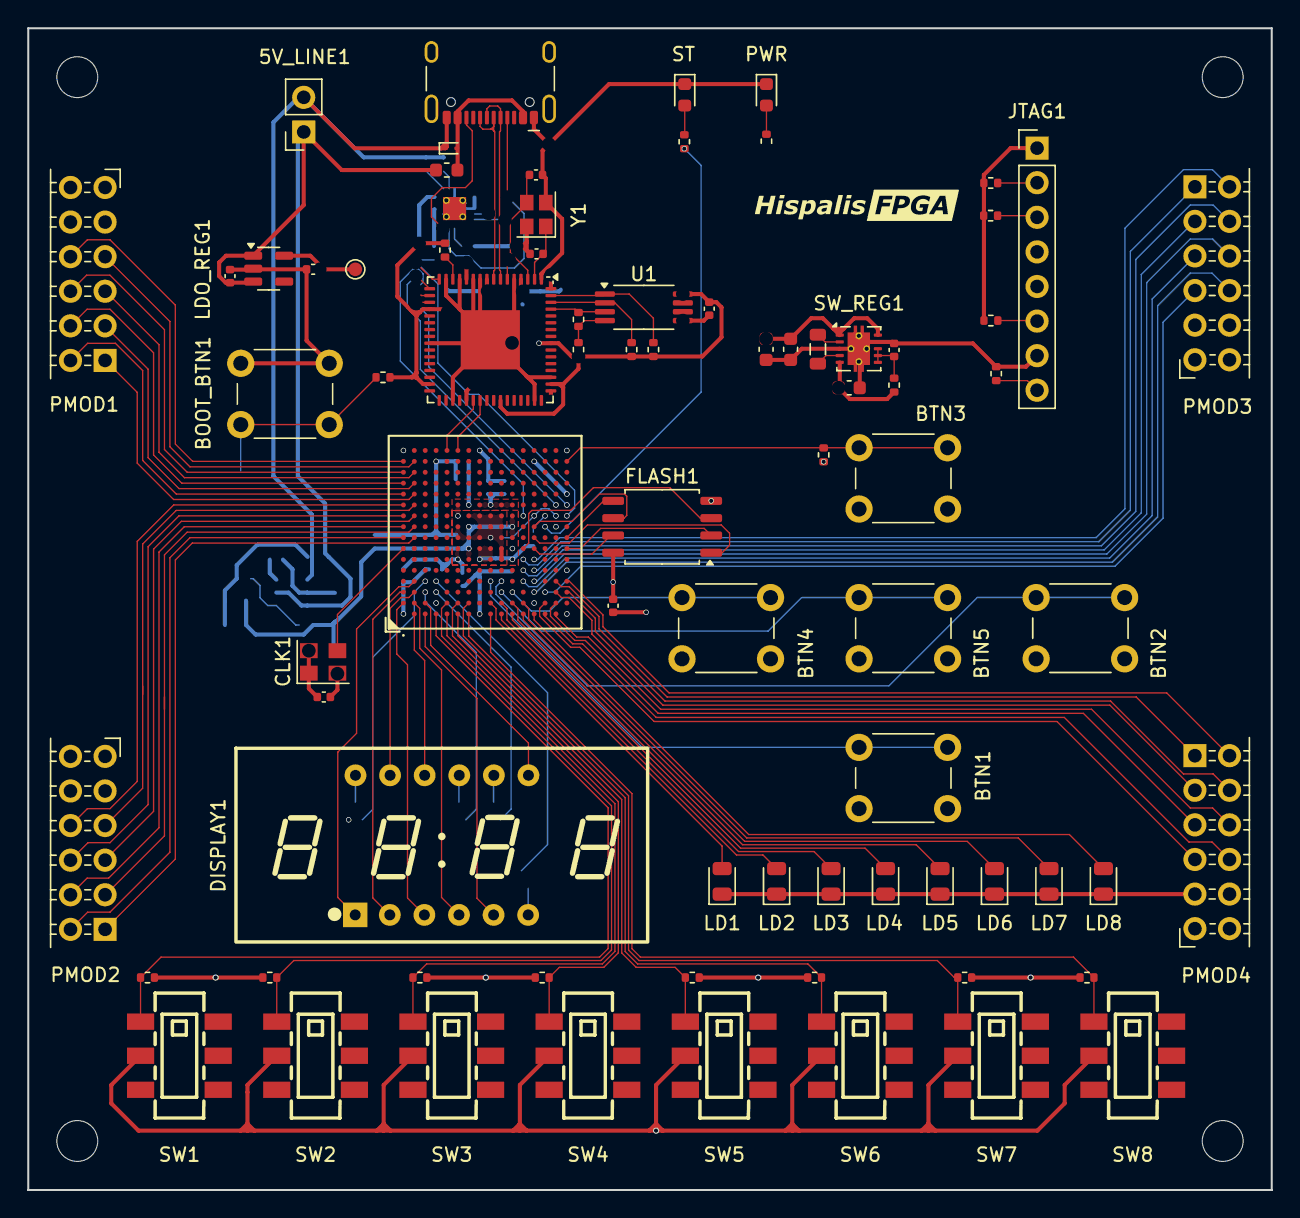
[picture p8: board HispalisFPGA.kicad_pcb from above]

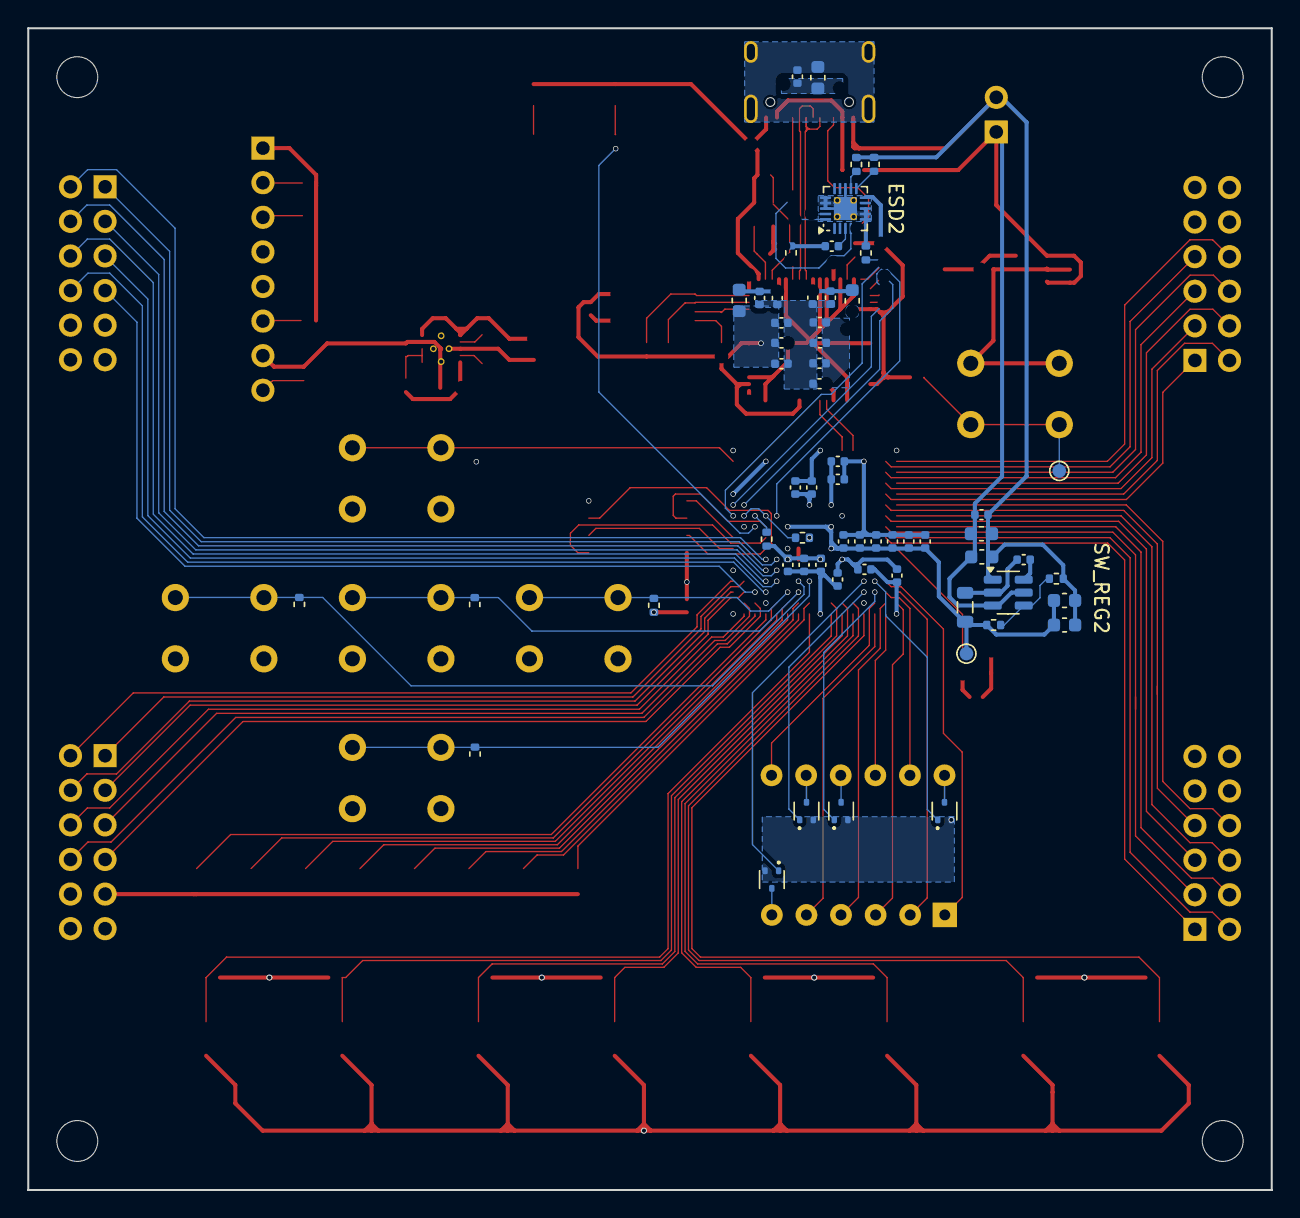
[picture p9: board HispalisFPGA.kicad_pcb from below]

Board: 4 copper layers, 91.3 x 85.3 mm, 141 parts (59 on the bottom side), 119 nets.

Other parts of the board:
HISPALISFPGA-LOGO1: HISPALISFPGA-LOGO; HispalisFPGA-Logo
MH01, MH02, MH03, MH04: MountingHole_3mm
