aledomu/HispalisFPGA/(commit log)

2024-04-03 Rename and update project
    [HispalisFPGA.kicad_pcb, HispalisFPGA.kicad_sch, TinyFPGA-EX.sch]
2024-04-08 Add PMODs, LEDs, switches and buttons
    [HispalisFPGA.kicad_sch]
2024-04-11 Add 7-segment 4-digit display and annotate components
    [HispalisFPGA.kicad_sch]
2024-04-24 Fix and adjust power connections
    [HispalisFPGA.kicad_sch]
2024-04-25 Fix LEDs polarity
    [HispalisFPGA.kicad_sch]
2024-04-26 Add socket wire for 5V power input-output
    [HispalisFPGA.kicad_sch]
2024-04-30 Simplify USB connections
    [HispalisFPGA.kicad_sch]
2024-05-02 Assign generic footprints
    [HispalisFPGA.kicad_sch]
2024-05-03 Cleanup unused symbols
    [HispalisFPGA.kicad_sch]
2024-05-03 Re-annotate schematic and fix broken wires
    [HispalisFPGA.kicad_sch]
2024-05-03 Rearrange USB connections
    [HispalisFPGA.kicad_sch]
2024-05-06 Fix power connections
    [HispalisFPGA.kicad_sch]
2024-05-06 Check clocks
    [HispalisFPGA.kicad_sch]
2024-05-31 Component selection for assembly
    [HispalisFPGA.kicad_sch]
2024-05-31 Remove unnecessary resistors for LEDs
    [HispalisFPGA.kicad_sch]
2024-06-03 Power and status LED correction
    [HispalisFPGA.kicad_sch]
2024-06-06 Improve USB port protections
    [HispalisFPGA.kicad_sch]
2024-06-07 Make all display pins activate on high signal from FPGA pins
    [HispalisFPGA.kicad_sch]
2024-06-10 Fix resistor value
    [HispalisFPGA.kicad_sch]
2024-06-11 Replace SPI flash device for a cheaper one
    [HispalisFPGA.kicad_sch]
2024-06-14 Remove SDRAM block
    [HispalisFPGA.kicad_sch]
2024-06-14 Rearrange, cleanup and reannotate schematic
    [HispalisFPGA.kicad_sch]
2024-06-17 Replace 1.1V regulator
    [HispalisFPGA.kicad_sch]
2024-06-18 Add missing ESD on 5V power line
    [HispalisFPGA.kicad_sch]
2024-06-18 Regenerate PCB layout file
    [HispalisFPGA.kicad_pcb]
2024-06-19 Set manufacturer constraints and track widths
    [HispalisFPGA.kicad_pcb]
2024-06-24 Final connection of ECP5 chip
    [HispalisFPGA.kicad_pcb, HispalisFPGA.kicad_sch]
2024-10-02 Change USB 3.1 for USB 2.0 Type-C and use JTAG and serial USB controller
    [HispalisFPGA.kicad_pcb, HispalisFPGA.kicad_sch]
2024-10-02 Subdivide schematic
    [HispalisFPGA.kicad_pcb, HispalisFPGA.kicad_sch, connectors.kicad_sch, ecp5-connections.kicad_sch, ecp5-io-ports.kicad_sch, ftdi-usb-controller.kicad_sch, io-devices.kicad_sch, power.kicad_sch]
2024-10-04 Complete schematic
    [HispalisFPGA.kicad_pcb, HispalisFPGA.kicad_sch, connectors.kicad_sch, ecp5-aux-connections.kicad_sch, ecp5-io-ports.kicad_sch, ftdi-usb-controller.kicad_sch, power.kicad_sch]
2024-10-10 Finish routing and remove unneeded silkscreen
    [HispalisFPGA.kicad_pcb, connectors.kicad_sch, ecp5-io-ports.kicad_sch, ftdi-usb-controller.kicad_sch, power.kicad_sch]
2024-10-17 No errors
    [HispalisFPGA.kicad_pcb]
2024-10-21 No warnings
    [HispalisFPGA.kicad_pcb]
2024-10-21 Add metadata
    [HispalisFPGA.kicad_pcb, HispalisFPGA.kicad_sch, ecp5-clock-and-programming.kicad_sch, ecp5-core-connections.kicad_sch, ecp5-io-connections.kicad_sch, ecp5-io-pins.kicad_sch, ftdi-usb-controller.kicad_sch, onboard-devices.kicad_sch]
2024-10-30 Add logo
    [HispalisFPGA.kicad_pcb]
2025-01-14 Further adaptations for JLCPCB order
    [HispalisFPGA.kicad_pcb]
2025-01-14 Move logo footprint to the right directory
    [HispalisFPGA.kicad_pcb]
2025-01-14 Fix USB connector margin between pads and holes
    [HispalisFPGA.kicad_pcb, ports.kicad_sch]
2025-01-14 Fix 1.1V regulator reference
    [HispalisFPGA.kicad_pcb, power.kicad_sch]
2025-01-14 Change switches
    [HispalisFPGA.kicad_pcb, ecp5-clock-and-programming.kicad_sch, ecp5-io-pins.kicad_sch, ftdi-usb-controller.kicad_sch, onboard-devices.kicad_sch]
2025-02-10 Set display symbol and footprint from EasyEDA
    [HispalisFPGA.kicad_pcb, ecp5-io-pins.kicad_sch, onboard-devices.kicad_sch]
2025-02-10 Change LFE5U chip from BGA381 to BGA256 package
    [HispalisFPGA.kicad_pcb, HispalisFPGA.kicad_sch, ecp5-clock-and-programming.kicad_sch, ecp5-io-pins-1.kicad_sch, ecp5-io-pins-2.kicad_sch, ftdi-usb-controller.kicad_sch, onboard-devices.kicad_sch, ports.kicad_sch]
2025-04-14 Update to KiCAD 9.0
    [HispalisFPGA.kicad_pcb, HispalisFPGA.kicad_sch, ecp5-clock-and-programming.kicad_sch, ecp5-io-pins-1.kicad_sch, ecp5-io-pins-2.kicad_sch, ftdi-usb-controller.kicad_sch, onboard-devices.kicad_sch, ports.kicad_sch]
2025-04-14 Change JTAG pin header parts reference
    [HispalisFPGA.kicad_pcb, ports.kicad_sch]
